MartijnBraam/mv2_base/mv2_base.kicad_pcb

## KiCad design mv2_base.kicad_pcb (2025-06-11)

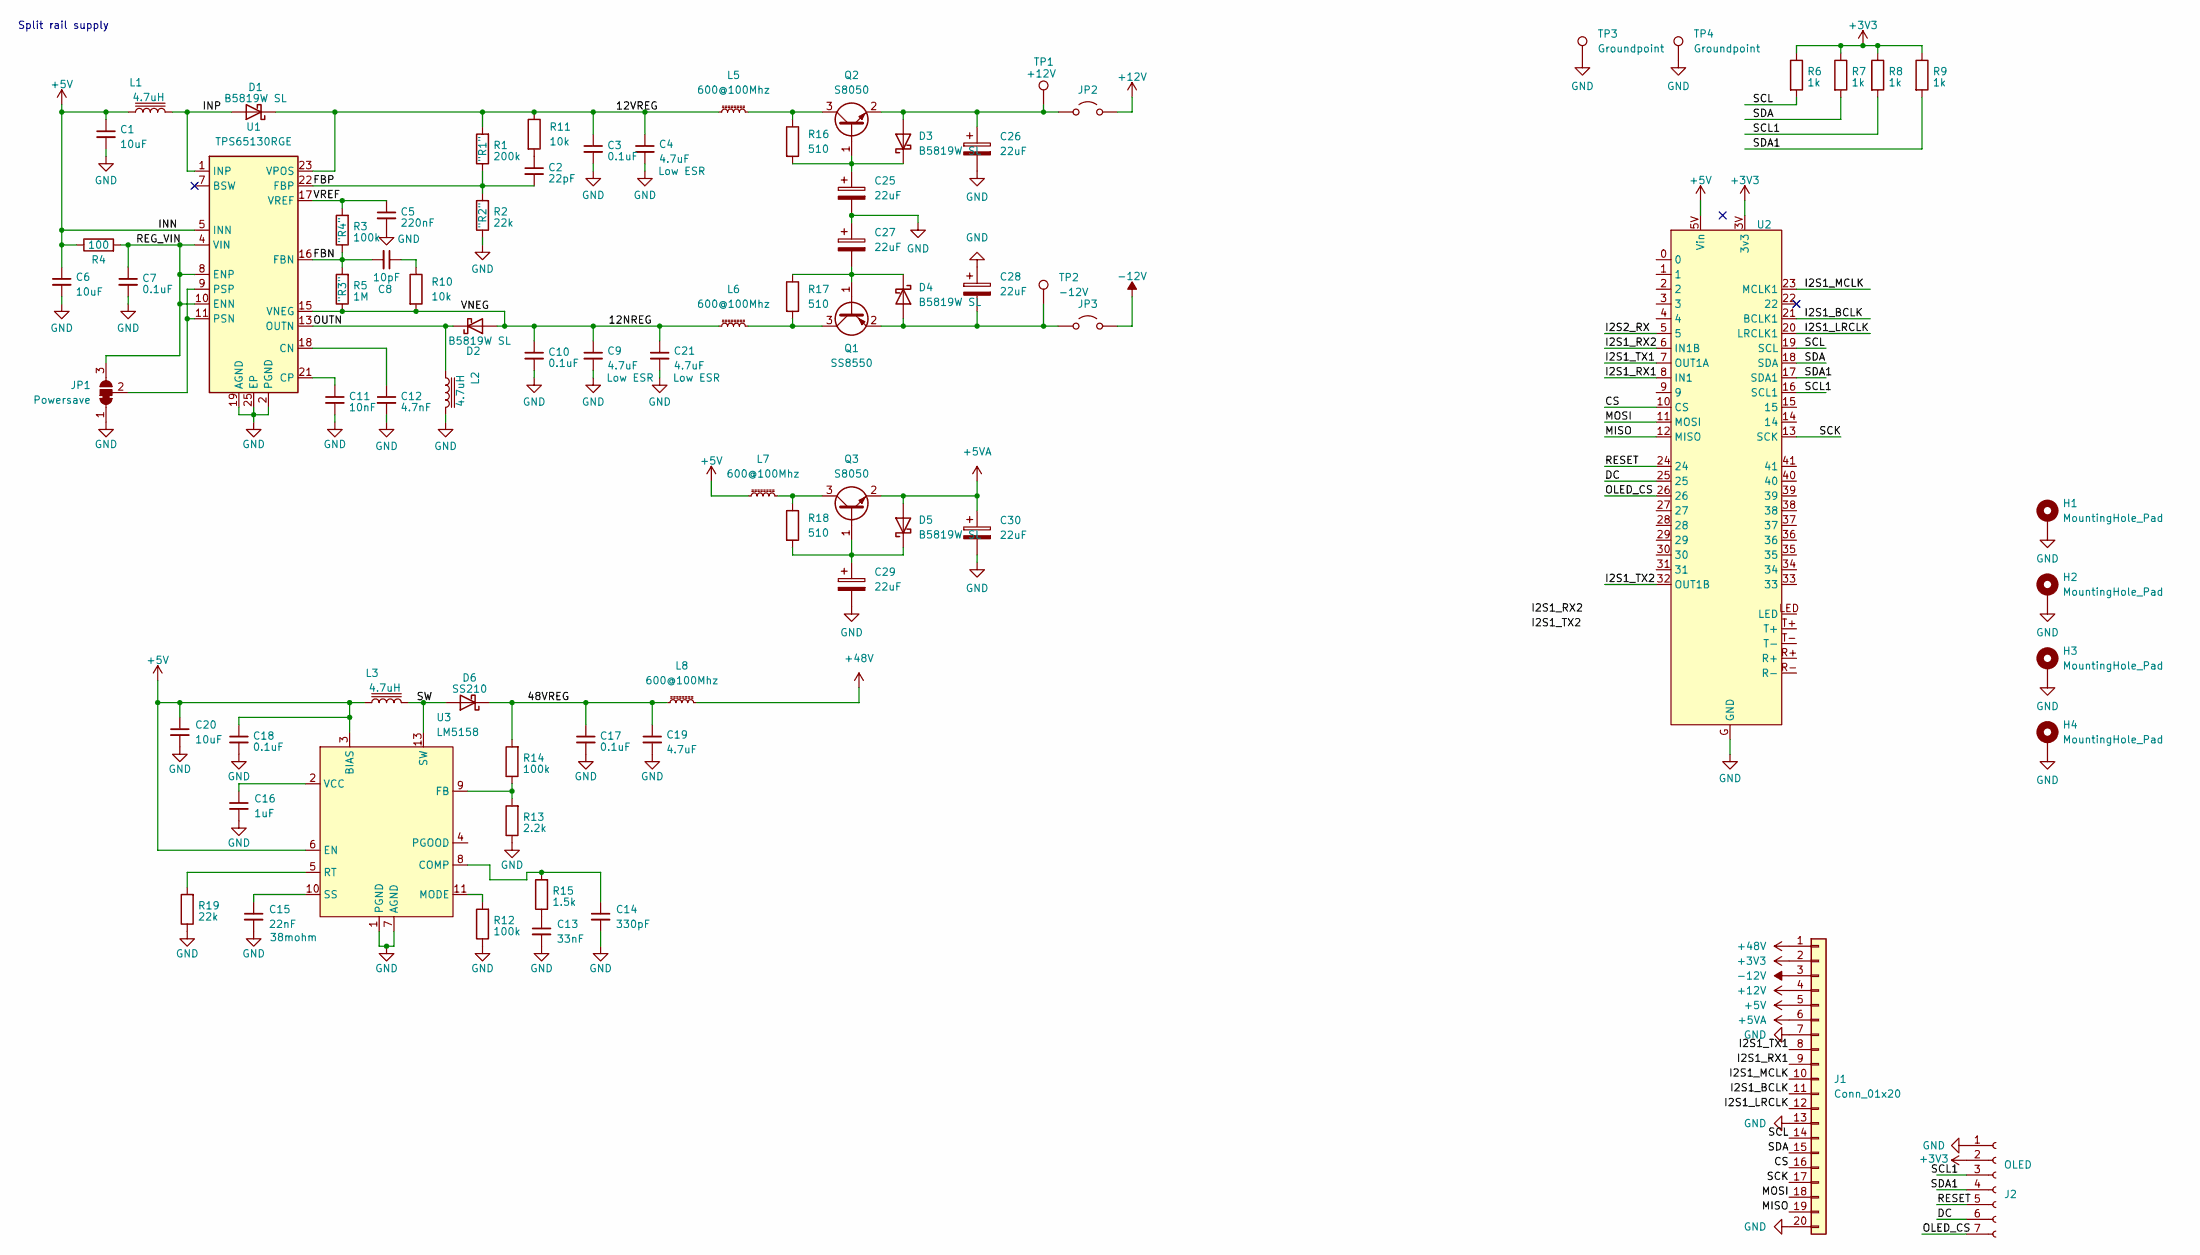
[picture p1: schematic mv2_base.kicad_sch]

Parts:
C1, C20: 10uF; C_0805_2012Metric_Pad1.18x1.45mm_HandSolder; LCSC C15850
C2: 22pF; C_0402_1005Metric; LCSC C1555
C3: 0.1uF; C_0603_1608Metric_Pad1.08x0.95mm_HandSolder; LCSC C14663
C4: 4.7uF; C_0805_2012Metric_Pad1.18x1.45mm_HandSolder; LCSC C1779
C5: 220nF; C_0402_1005Metric; LCSC C16772
C6: 10uF; C_0805_2012Metric; LCSC C15850
C7, C10, C17, C18: 0.1uF; C_0402_1005Metric; LCSC C307331
C8: 10pF; C_0402_1005Metric; LCSC C32949
C9, C19, C21: 4.7uF; C_0805_2012Metric; LCSC C1779
C11: 10nF; C_0402_1005Metric; LCSC C15195
C12: 4.7nF; C_0402_1005Metric; LCSC C1538
C13: 33nF; C_0603_1608Metric; LCSC C21117
C14: 330pF; C_0603_1608Metric; LCSC C1664
C15: 22nF; C_0402_1005Metric; LCSC C1532
C16: 1uF; C_0402_1005Metric; LCSC C52923
C25, C26, C27, C28, C29, C30: 22uF; C_0805_2012Metric; LCSC C45783
D1, D2, D3, D4, D5: B5819W SL; D_SOD-123; LCSC C8598
D6: SS210; D_SMA; LCSC C14996
H1, H2, H3, H4: MountingHole_Pad; MountingHole_3.2mm_M3_Pad_Via
J1: Conn_01x20; PinHeader_1x20_P2.54mm_Vertical
J2: OLED; PinHeader_1x07_P2.54mm_Vertical
JP1: Powersave; SolderJumper-3_P1.3mm_Bridged2Bar12_Pad1.0x1.5mm_NumberLabe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
JP2, JP3: Jumper_2_Open; PinHeader_1x02_P2.54mm_Vertical
L1, L2, L3: 4.7uH; L_Wuerth_WE-TPC-3816; MPN 744031004
L5, L6, L7, L8: 600@100Mhz; L_0603_1608Metric; LCSC C1002
Q1: SS8550; SOT-23; LCSC C8542
Q2, Q3: S8050; SOT-23; LCSC C2146
R1: 200k; R_0402_1005Metric; LCSC C25764
R2, R19: 22k; R_0402_1005Metric; LCSC C25768
R3, R12, R14: 100k; R_0402_1005Metric; LCSC C25741
R4: 100; R_0402_1005Metric; LCSC C25076
R5: 1M; R_0402_1005Metric; LCSC C26083
R6, R7, R8, R9: 1k; R_0603_1608Metric_Pad0.98x0.95mm_HandSolder; LCSC C21190
R10, R11: 10k; R_0402_1005Metric
R13: 2.2k; R_0402_1005Metric; LCSC C25879
R15: 1.5k; R_0402_1005Metric; LCSC C25867
R16, R17, R18: 510; R_0402_1005Metric; LCSC C25123
TP1: +12V; TestPoint_Plated_Hole_D2.0mm
TP2: -12V; TestPoint_Plated_Hole_D2.0mm
TP3, TP4: Groundpoint; TestPoint_Bridge_Pitch2.54mm_Drill1.0mm
U1: TPS65130RGE; VQFN-24-1EP_4x4mm_P0.5mm_EP2.45x2.45mm_ThermalVias; LCSC C54989
U2: Teensy41
U3: LM5158; WQFN-16-1EP_3x3mm_P0.5mm_EP1.68x1.68mm_ThermalVias

Connections:
+3V3: J1.2, J2.2, R6.1, R7.1, R8.1, R9.1, U2.3V (3v3)
+5V: C1.1, C6.1, C18.1, C20.1, J1.5, L1.2, L3.2, L7.1, R4.1, U1.5 (INN), U1.6 (INN), U2.5V (Vin), U3.3 (BIAS), U3.6 (EN)
+5VA: C30.1, D5.2 (A), J1.6, Q3.2 (E)
+12V: J1.4, JP2.2 (B)
+48V: J1.1, L8.2
-12V: J1.3, JP3.2 (B)
/12NREG: C9.1, C10.1, C21.1, D2.2 (A), L6.1, R5.1, R10.2, U1.15 (VNEG)
/12VREG: C3.1, C4.1, D1.1 (K), L5.1, R1.2, R11.1, U1.23 (VPOS)
/48VREG: C17.1, C19.1, D6.1 (K), L8.1, R14.2
/CS: J1.16, U2.10 (CS)
/DC: J2.6, U2.25
/FBN: C8.2, R3.1, R5.2, U1.16 (FBN)
/FBP: C2.2, R1.1, R2.2, U1.22 (FBP)
/I2S1_BCLK: J1.11, U2.21 (BCLK1)
/I2S1_LRCLK: J1.12, U2.20 (LRCLK1)
/I2S1_MCLK: J1.10, U2.23 (MCLK1)
/I2S1_RX1: J1.9, U2.8 (IN1)
/I2S1_RX2: U2.6 (IN1B)
/I2S1_TX1: J1.8, U2.7 (OUT1A)
/I2S1_TX2: U2.32 (OUT1B)
/I2S2_RX: U2.5
/INP: D1.2 (A), L1.1, U1.1 (INP), U1.24 (INP)
/MISO: J1.19, U2.12 (MISO)
/MOSI: J1.18, U2.11 (MOSI)
/OLED_CS: J2.7, U2.26
/OUTN: D2.1 (K), L2.2, U1.13 (OUTN), U1.14 (OUTN)
/REG_VIN: C7.1, JP1.3 (B), R4.2, U1.4 (VIN), U1.8 (ENP), U1.10 (ENN)
/RESET: J2.5, U2.24
/SCK: J1.17, U2.13 (SCK)
/SCL: J1.14, R6.2, U2.19 (SCL)
/SCL1: J2.3, R8.2, U2.16 (SCL1)
/SDA: J1.15, R7.2, U2.18 (SDA)
/SDA1: J2.4, R9.2, U2.17 (SDA1)
/SW: D6.2 (A), L3.1, U3.13 (SW), U3.14 (SW)
/VREF: C5.1, R3.2, U1.17 (VREF)
GND: C1.2, C3.2, C4.2, C5.2, C6.2, C7.2, C9.2, C10.2, C11.2, C12.2, C13.2, C14.2, C15.2, C16.2, C17.2, C18.2, C19.2, C20.2, C21.2, C25.2, C26.2, C27.1, C28.1, C29.2, C30.2, H1.1, H2.1, H3.1, H4.1, J1.7, J1.13, J1.20, J2.1, JP1.1 (A), L2.1, R2.1, R12.1, R13.1, R19.1, TP3.1, TP4.1, U1.2 (PGND), U1.3 (PGND), U1.19 (AGND), U1.25 (EP), U2.G (GND), U3.1 (PGND), U3.7 (AGND), U3.16 (PGND)
unnamed: C2.1, R11.2
unnamed: C8.1, R10.1
unnamed: C13.1, R15.1
unnamed: C26.1, D3.2 (A), JP2.1 (A), Q2.2 (E), TP1.1
unnamed: C25.1, D3.1 (K), Q2.1 (B), R16.2
unnamed: C28.2, D4.2 (A), JP3.1 (A), Q1.2 (E), TP2.1
unnamed: C27.2, D4.1 (K), Q1.1 (B), R17.1
unnamed: C29.1, D5.1 (K), Q3.1 (B), R18.2
unnamed: JP1.2 (C), U1.9 (PSP), U1.11 (PSN)
unnamed: L6.2, Q1.3 (C), R17.2
unnamed: L5.2, Q2.3 (C), R16.1
unnamed: L7.2, Q3.3 (C), R18.1
unnamed: C12.1, U1.18 (CN)
unnamed: C11.1, U1.21 (CP)
unnamed: C14.1, R15.2, U3.8 (COMP)
unnamed: R13.2, R14.1, U3.9 (FB)
unnamed: R12.2, U3.11 (MODE)
unnamed: R19.2, U3.5 (RT)
unnamed: C15.1, U3.10 (SS)
unnamed: C16.1, U3.2 (VCC)

Notes on the sheet:
Split rail supply

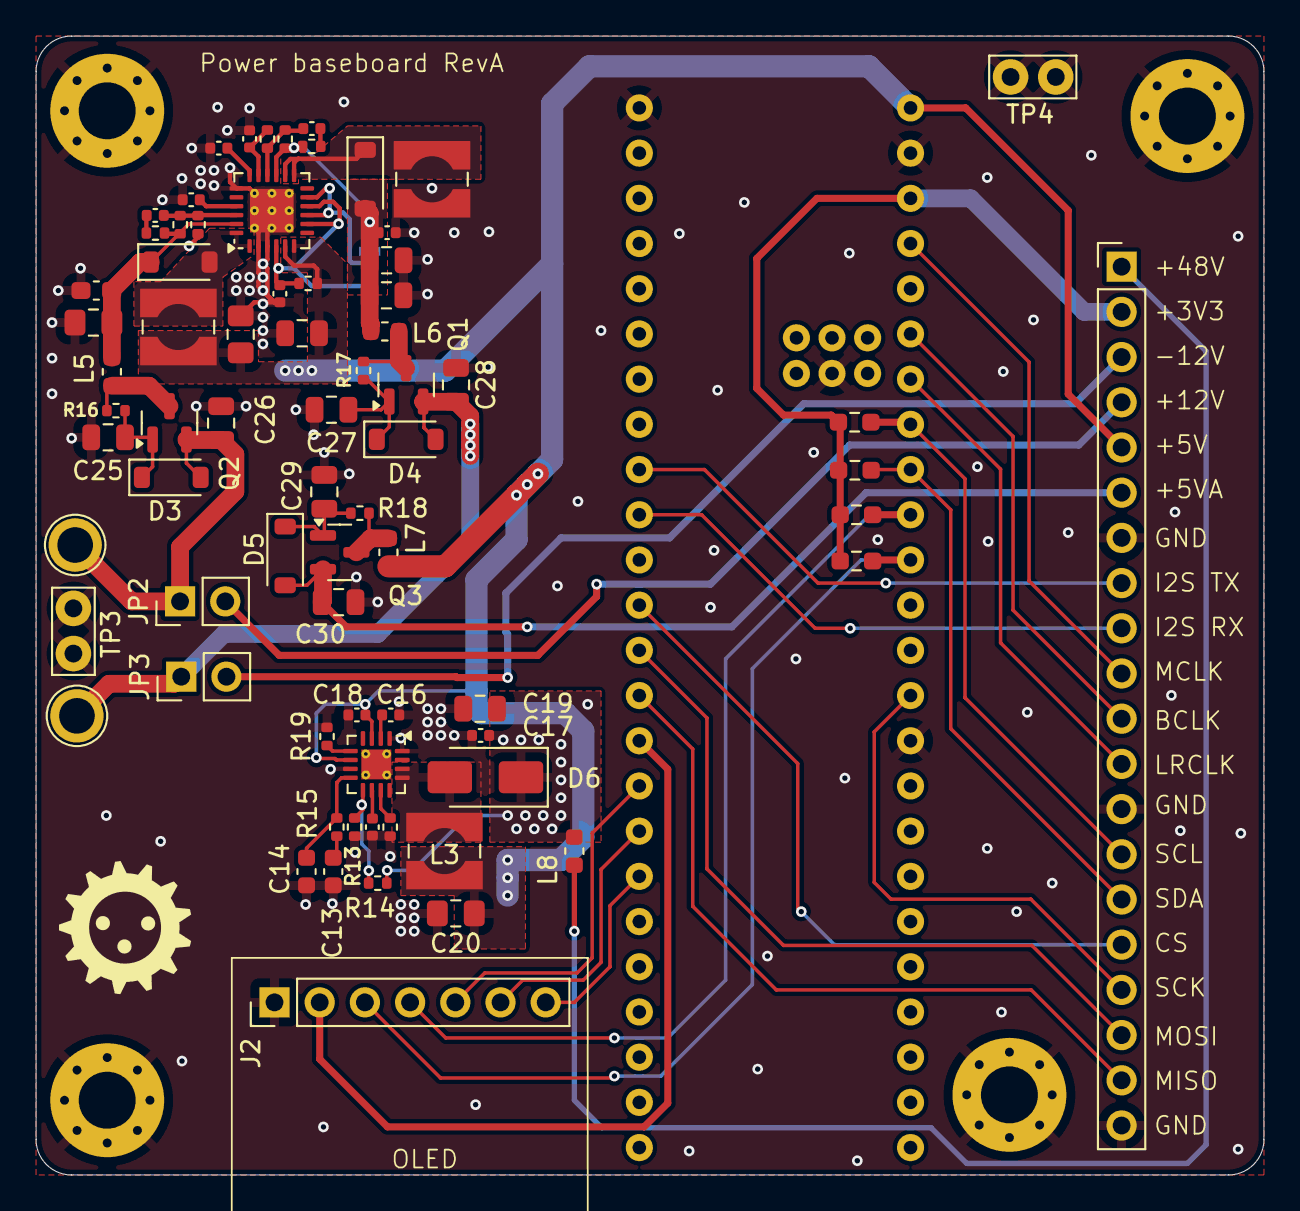
[picture p2: board mv2_base.kicad_pcb from above]

Board: 4 copper layers, 69.0 x 64.0 mm, 78 parts (1 on the bottom side), 53 nets.
