MartijnBraam/mv2_base/(commit log)

2025-02-07 Add jumpers in power rails and more test points
    [mv2_base.kicad_pcb, mv2_base.kicad_sch]
2025-03-23 New filters
    [mv2_base.kicad_pcb, mv2_base.kicad_sch]
2025-03-24 Implement +48V supply
    [mv2_base.kicad_pcb, mv2_base.kicad_sch]
2025-06-11 Fix up some LCSC part numbers
    [mv2_base.kicad_sch]
2025-06-11 DRC fixes
    [mv2_base.kicad_pcb]
2025-06-11 Replace 500ohm resistor with 510ohm basic part
    [mv2_base.kicad_pcb, mv2_base.kicad_sch]
